MrPaulAR/PB_16/SM_Receiver_Out_SMD/Receiver_Out.kicad_pcb

## KiCad design SM_Receiver_Out_SMD/Receiver_Out.kicad_pcb (2026-10-05)

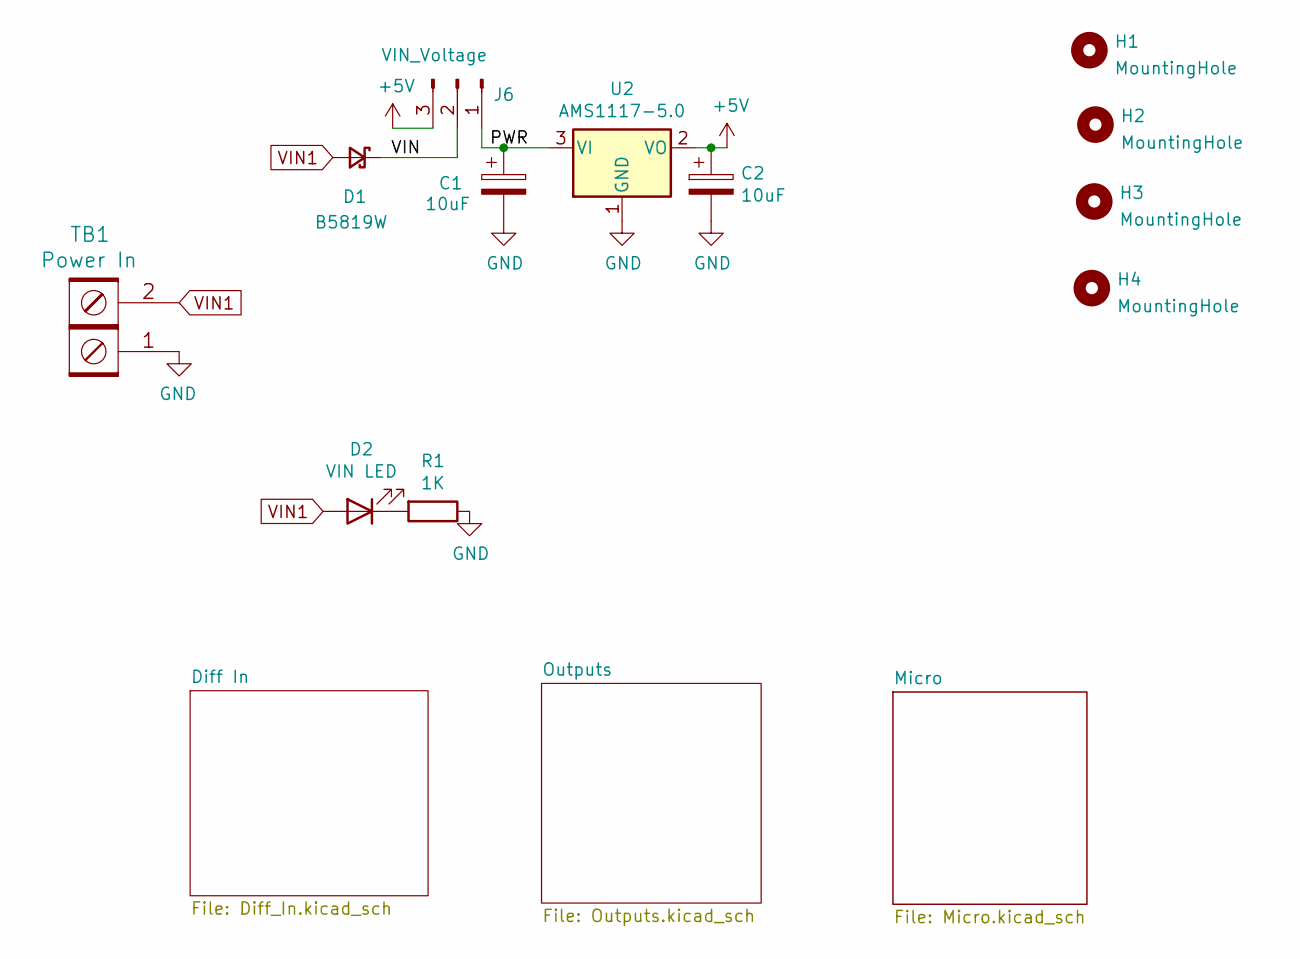
[picture p2: schematic Receiver_Out.kicad_sch, SM Receiver Out SMD]

Parts:
C1, C2: 10uF; C_0805_2012Metric_Pad1.18x1.45mm_HandSolder; MPN GRM21BR61E106KA73L; Digi-Key_PN 490-5523-1-ND
D1: B5819W; D_SOD-123; MPN B5819W-TP; LCSC_PN C8598
D2: VIN LED; LED_0603_1608Metric_Pad1.05x0.95mm_HandSolder; MPN 150080RS75000; Digi-Key_PN 732-4984-1-ND
H1, H2, H3, H4: MountingHole; MountingHole_3.7mm
J6: VIN_Voltage; PinHeader_1x03_P2.54mm_Vertical; MPN 61300311121; Digi-Key_PN 732-5316-ND
R1: 1K; R_0603_1608Metric_Pad0.98x0.95mm_HandSolder; MPN RC0603FR-071KL; Digi-Key_PN 311-1.00KHRCT-ND
TB1: Power In; BARRIER_BLOCK_1ROW_2POS; MPN 4DB-P108-02; Digi-Key_PN A98472-ND
U2: AMS1117-5.0; SOT-223-3_TabPin2; MPN LM1117MPX-50NOPB; LCSC_PN C6187

Connections:
+5V: C2.1, J6.3, U2.2 (VO); also elsewhere on the board
/PWR: C1.1, J6.1, U2.3 (VI)
/VIN: D1.1 (K), J6.2
GND: C1.2, C2.2, R1.1, TB1.1, U2.1 (GND); also elsewhere on the board
unnamed: D2.1 (K), R1.2
VIN1: D1.2 (A), D2.2 (A), TB1.2; also elsewhere on the board

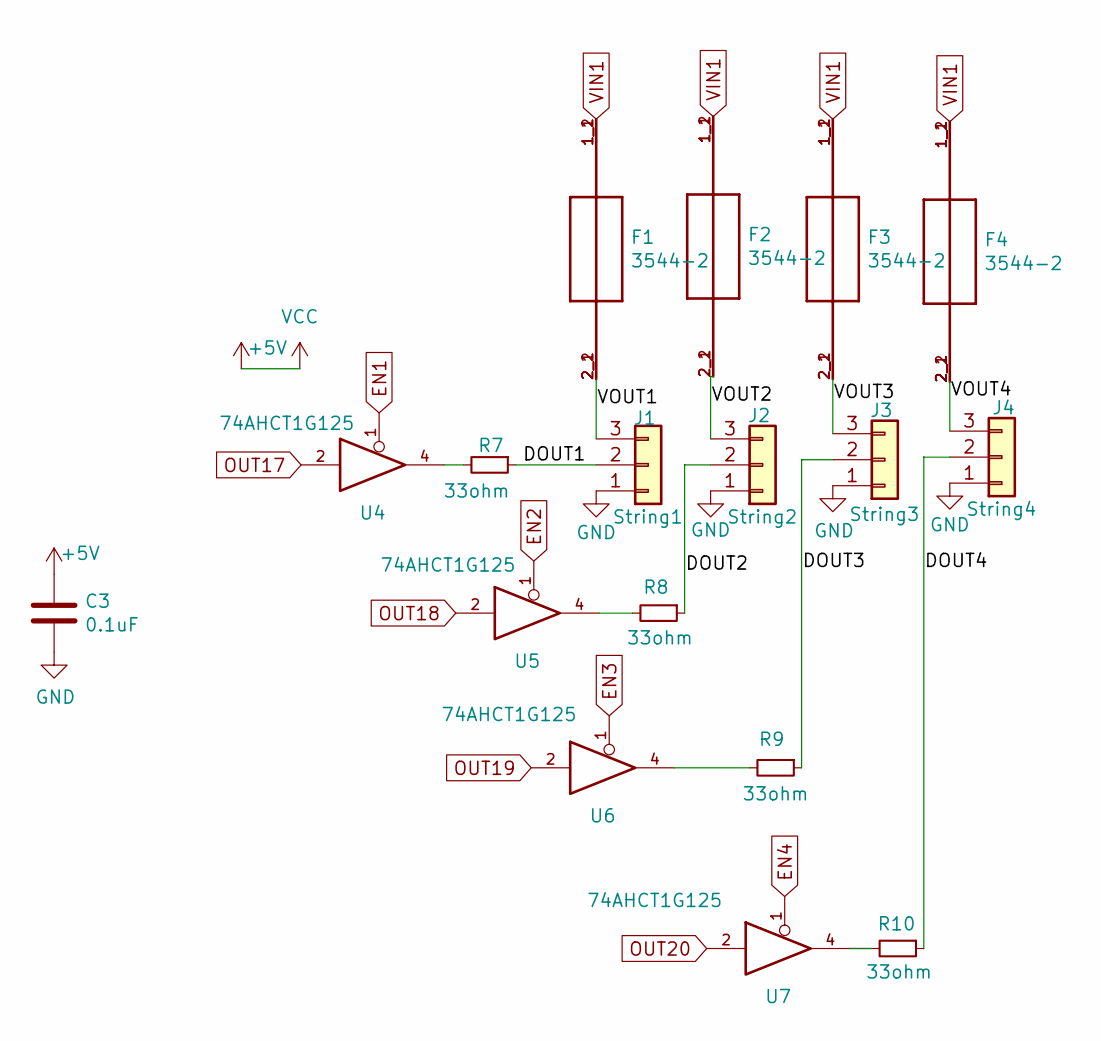
[picture p3: schematic Outputs.kicad_sch, SM Receiver Out SMD]

Parts:
C3: 0.1uF; C_0603_1608Metric_Pad1.08x0.95mm_HandSolder; MPN CL10B104KB8NNWC; Digi-Key_PN 1276-1935-2-ND
F1, F2, F3, F4: 3544-2; FUSE_3544-2; MPN 3544-2; Digi-Key_PN 36-3544-2-ND
J1: String1; PhoenixContact_MCV_1,5_3-G-3.5_1x03_P3.50mm_Vertical; MPN 1843619/OSTTJ0311530; Digi-Key_PN 277-5737-ND/ED10555-ND
J2: String2; PhoenixContact_MCV_1,5_3-G-3.5_1x03_P3.50mm_Vertical; MPN 1843619/OSTTJ0311530; Digi-Key_PN 277-5737-ND/ED10555-ND
J3: String3; PhoenixContact_MCV_1,5_3-G-3.5_1x03_P3.50mm_Vertical; MPN 1843619/OSTTJ0311530; Digi-Key_PN 277-5737-ND/ED10555-ND
J4: String4; PhoenixContact_MCV_1,5_3-G-3.5_1x03_P3.50mm_Vertical; MPN 1843619/OSTTJ0311530; Digi-Key_PN 277-5737-ND/ED10555-ND
R7, R8, R9, R10: 33ohm; R_0603_1608Metric_Pad0.98x0.95mm_HandSolder; MPN RC0603JR-0733RL; LCSC_PN C23140
U4, U5, U6, U7: 74AHCT1G125; TSOP-5_1.65x3.05mm_P0.95mm; MPN 74AHCT1G125W5-7; Digi-Key_PN 74AHCT1G125W5-7DICT-ND

Connections:
+5V: C3.1, U4.5 (VCC), U5.5 (VCC), U6.5 (VCC), U7.5 (VCC); also elsewhere on the board
/Outputs/DOUT1: J1.2, R7.1
/Outputs/DOUT2: J2.2, R8.1
/Outputs/DOUT3: J3.2, R9.1
/Outputs/DOUT4: J4.2, R10.1
/Outputs/VOUT1: F1.2_1 (2), F1.2_2 (2), J1.3
/Outputs/VOUT2: F2.2_1 (2), F2.2_2 (2), J2.3
/Outputs/VOUT3: F3.2_1 (2), F3.2_2 (2), J3.3
/Outputs/VOUT4: F4.2_1 (2), F4.2_2 (2), J4.3
EN1: U4.1; also elsewhere on the board
EN2: U5.1; also elsewhere on the board
EN3: U6.1; also elsewhere on the board
EN4: U7.1; also elsewhere on the board
GND: C3.2, J1.1, J2.1, J3.1, J4.1, U4.3 (GND), U5.3 (GND), U6.3 (GND), U7.3 (GND); also elsewhere on the board
unnamed: R7.2, U4.4
unnamed: R8.2, U5.4
unnamed: R9.2, U6.4
unnamed: R10.2, U7.4
OUT17: U4.2; also elsewhere on the board
OUT18: U5.2; also elsewhere on the board
OUT19: U6.2; also elsewhere on the board
OUT20: U7.2; also elsewhere on the board
VIN1: F1.1_1 (1), F1.1_2 (1), F2.1_1 (1), F2.1_2 (1), F3.1_1 (1), F3.1_2 (1), F4.1_1 (1), F4.1_2 (1); also elsewhere on the board

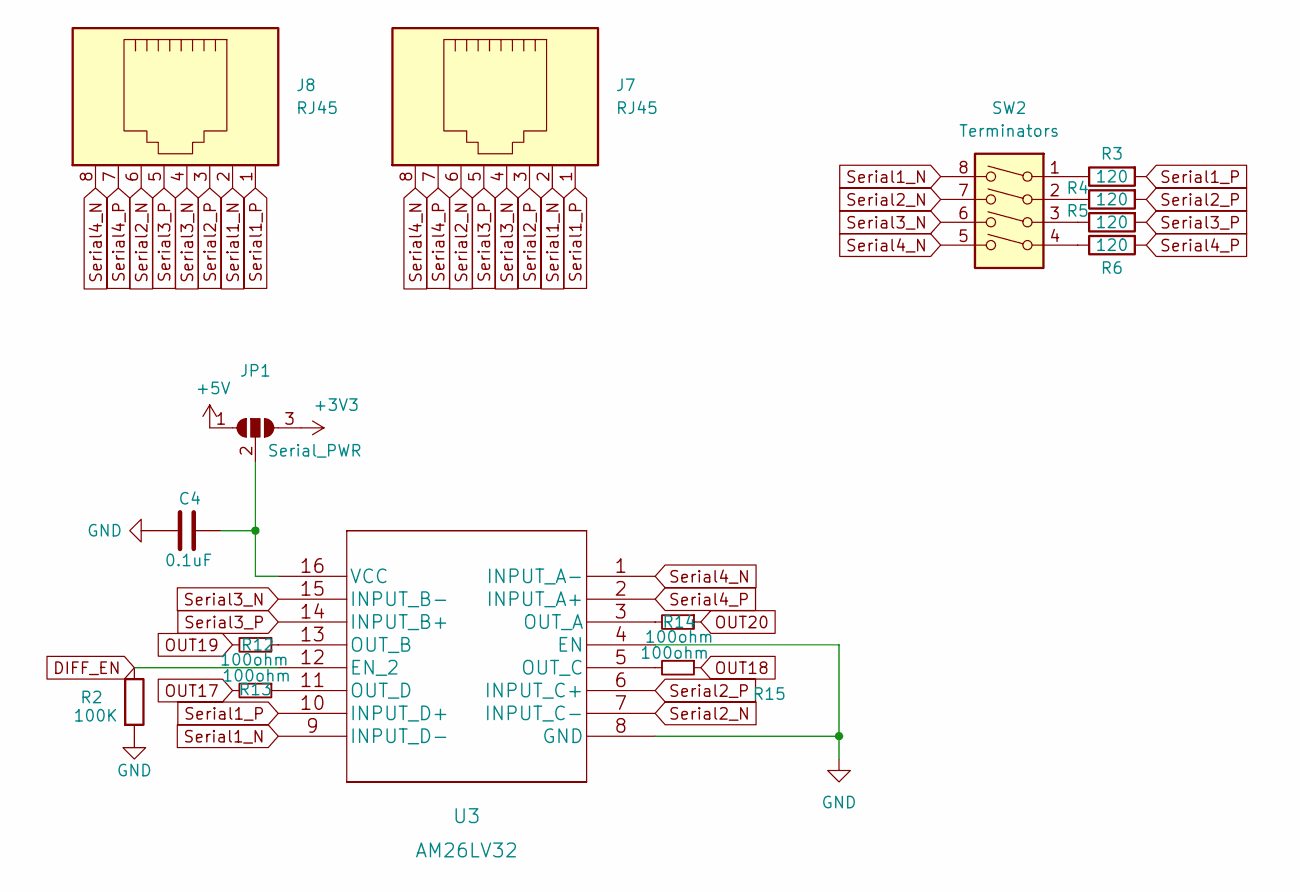
[picture p4: schematic Diff_In.kicad_sch, SM Receiver Out SMD]

Parts:
C4: 0.1uF; C_0603_1608Metric_Pad1.08x0.95mm_HandSolder; MPN CL10B104KB8NNWC; Digi-Key_PN 1276-1935-2-ND
J7, J8: RJ45; RJ45_Amphenol_54602-x08_Horizontal; MPN A-2014-2-4-R; Digi-Key_PN AE10392-ND
JP1: Serial_PWR; SolderJumper-3_P2.0mm_Open_TrianglePad1.0x1.5mm
R2: 100K; R_0603_1608Metric_Pad0.98x0.95mm_HandSolder; MPN RT0603BRD07100KL; Digi-Key_PN YAG1235CT-ND
R3, R4, R5, R6: 120; R_0603_1608Metric_Pad0.98x0.95mm_HandSolder; MPN CRGCQ0603F120R; LCSC_PN C22787
R12, R13: 100ohm; R_0603_1608Metric_Pad0.98x0.95mm_HandSolder; LCSC_PN C22775
R14, R15: 100ohm; R_0603_1608Metric_Pad0.98x0.95mm_HandSolder; MPN RC0603FR-07100RL; LCSC_PN C22775
SW2: Terminators; SW_DIP_SPSTx04_Slide_6.7x11.72mm_W7.62mm_P2.54mm_LowProfile; MPN DS04-254-1L-04BK; Digi-Key_PN 2223-DS04-254-1L-04BK-ND
U3: AM26LV32; SOIC-16_3.9x9.9mm_P1.27mm; MPN AM26LV32IDR; Digi-Key_PN 296-18090-1-ND

Connections:
+3V3: JP1.3 (B); also elsewhere on the board
+5V: JP1.1 (A); also elsewhere on the board
DIFF_EN: R2.1, U3.12 (EN_2); also elsewhere on the board
GND: C4.2, R2.2, U3.4 (EN), U3.8 (GND); also elsewhere on the board
unnamed: C4.1, JP1.2 (C), U3.16 (VCC)
unnamed: R3.1, SW2.1
unnamed: R4.1, SW2.2
unnamed: R5.1, SW2.3
unnamed: R6.1, SW2.4
unnamed: R14.2, U3.3 (OUT_A)
unnamed: R12.1, U3.13 (OUT_B)
unnamed: R15.2, U3.5 (OUT_C)
unnamed: R13.1, U3.11 (OUT_D)
OUT17: R13.2; also elsewhere on the board
OUT18: R15.1; also elsewhere on the board
OUT19: R12.2; also elsewhere on the board
OUT20: R14.1; also elsewhere on the board
Serial1_N: J7.2, J8.2, SW2.8, U3.9 (INPUT_D-)
Serial1_P: J7.1, J8.1, R3.2, U3.10 (INPUT_D+)
Serial2_N: J7.6, J8.6, SW2.7, U3.7 (INPUT_C-)
Serial2_P: J7.3, J8.3, R4.2, U3.6 (INPUT_C+)
Serial3_N: J7.4, J8.4, SW2.6, U3.15 (INPUT_B-)
Serial3_P: J7.5, J8.5, R5.2, U3.14 (INPUT_B+)
Serial4_N: J7.8, J8.8, SW2.5, U3.1 (INPUT_A-)
Serial4_P: J7.7, J8.7, R6.2, U3.2 (INPUT_A+)

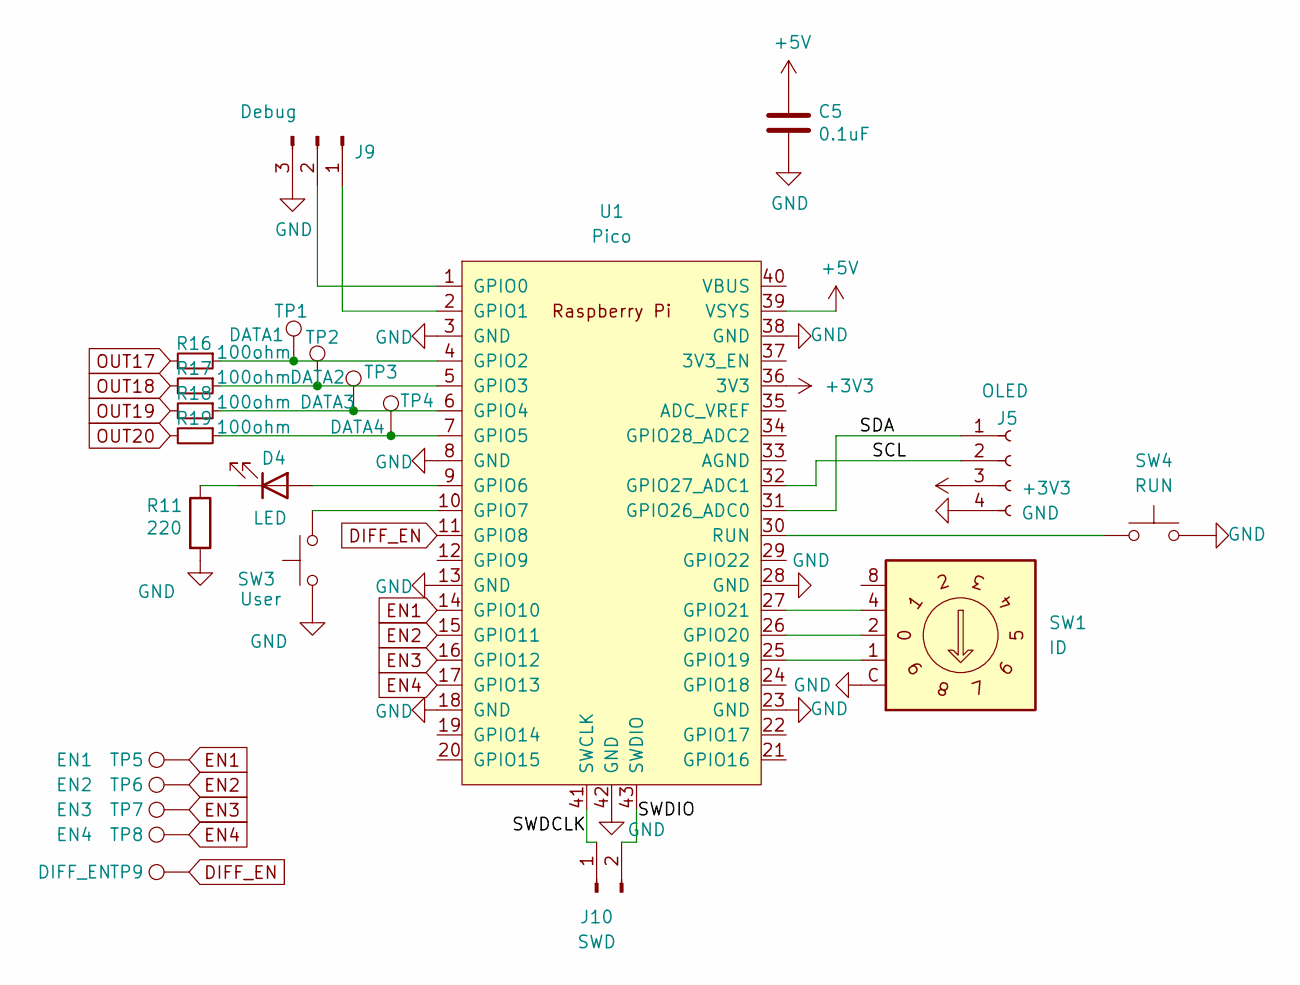
[picture p5: schematic Micro.kicad_sch, SM Receiver Out SMD]

Parts:
C5: 0.1uF; C_0603_1608Metric_Pad1.08x0.95mm_HandSolder; MPN CL10B104KB8NNWC; Digi-Key_PN 1276-1935-2-ND
D4: LED; LED_0603_1608Metric_Pad1.05x0.95mm_HandSolder; MPN 150080RS75000; Digi-Key_PN 732-4984-1-ND
J5: OLED; OLED-SSD1306-128X64-I2C-THT; MPN PPTC041LFBN-RC; Digi-Key_PN S7002-ND
J9: Debug; PinHeader_1x03_P2.54mm_Vertical; MPN 61300311121; Digi-Key_PN 732-5316-ND
J10: SWD; 1x02_Horizontal_SMD; MPN 61300211121; Digi-Key_PN 732-5315-ND
R11: 220; R_0603_1608Metric_Pad0.98x0.95mm_HandSolder; MPN RMCF0603FT220R; Digi-Key_PN RMCF0603FT220RTR-ND
R16, R17, R18, R19: 100ohm; R_0603_1608Metric_Pad0.98x0.95mm_HandSolder; MPN RC0603FR-07100RL; LCSC_PN C22775
SW1: ID; Nidec_Copal_SH-7010C; MPN SD-2010; Digi-Key_PN 563-1069-ND
SW3: User; SW_Push_1P1T_NO_6x6mm_H9.5mm; MPN PTS645SL50SMTR92 LFS; Digi-Key_PN CKN9088CT-ND
SW4: RUN; SW_Push_1P1T_NO_6x6mm_H9.5mm; MPN PTS645SL50SMTR92 LFS; Digi-Key_PN CKN9088CT-ND
TP1: DATA1; TestPoint_Pad_D1.5mm
TP2: DATA2; TestPoint_Pad_D1.5mm
TP3: DATA3; TestPoint_Pad_D1.5mm
TP4: DATA4; TestPoint_Pad_D1.5mm
TP5: EN1; TestPoint_Pad_D1.5mm
TP6: EN2; TestPoint_Pad_D1.5mm
TP7: EN3; TestPoint_Pad_D1.5mm
TP8: EN4; TestPoint_Pad_D1.5mm
TP9: DIFF_EN; TestPoint_Pad_D1.5mm
U1: Pico; RPi_Pico_SMD_TH; MPN 2648-SC0915CT-ND; Digi-Key_PN SC0915

Connections:
+3V3: J5.3, U1.36 (3V3); also elsewhere on the board
+5V: C5.1, U1.39 (VSYS); also elsewhere on the board
/Micro/SCL: J5.2, U1.32 (GPIO27_ADC1)
/Micro/SDA: J5.1, U1.31 (GPIO26_ADC0)
/Micro/SWDCLK: J10.1, U1.41 (SWCLK)
/Micro/SWDIO: J10.2, U1.43 (SWDIO)
DIFF_EN: TP9.1, U1.11 (GPIO8); also elsewhere on the board
EN1: TP5.1, U1.14 (GPIO10); also elsewhere on the board
EN2: TP6.1, U1.15 (GPIO11); also elsewhere on the board
EN3: TP7.1, U1.16 (GPIO12); also elsewhere on the board
EN4: TP8.1, U1.17 (GPIO13); also elsewhere on the board
GND: C5.2, J5.4, J9.3, R11.2, SW1.C, SW3.1, SW4.2, U1.3 (GND), U1.8 (GND), U1.13 (GND), U1.18 (GND), U1.23 (GND), U1.28 (GND), U1.38 (GND), U1.42 (GND); also elsewhere on the board
unnamed: D4.2 (A), U1.9 (GPIO6)
unnamed: D4.1 (K), R11.1
unnamed: J9.1, U1.2 (GPIO1)
unnamed: J9.2, U1.1 (GPIO0)
unnamed: R16.1, TP1.1, U1.4 (GPIO2)
unnamed: R17.1, TP2.1, U1.5 (GPIO3)
unnamed: R18.1, TP3.1, U1.6 (GPIO4)
unnamed: R19.1, TP4.1, U1.7 (GPIO5)
unnamed: SW3.2, U1.10 (GPIO7)
unnamed: SW1.1, U1.25 (GPIO19)
unnamed: SW1.2, U1.26 (GPIO20)
unnamed: SW1.4, U1.27 (GPIO21)
unnamed: SW4.1, U1.30 (RUN)
OUT17: R16.2; also elsewhere on the board
OUT18: R17.2; also elsewhere on the board
OUT19: R18.2; also elsewhere on the board
OUT20: R19.2; also elsewhere on the board

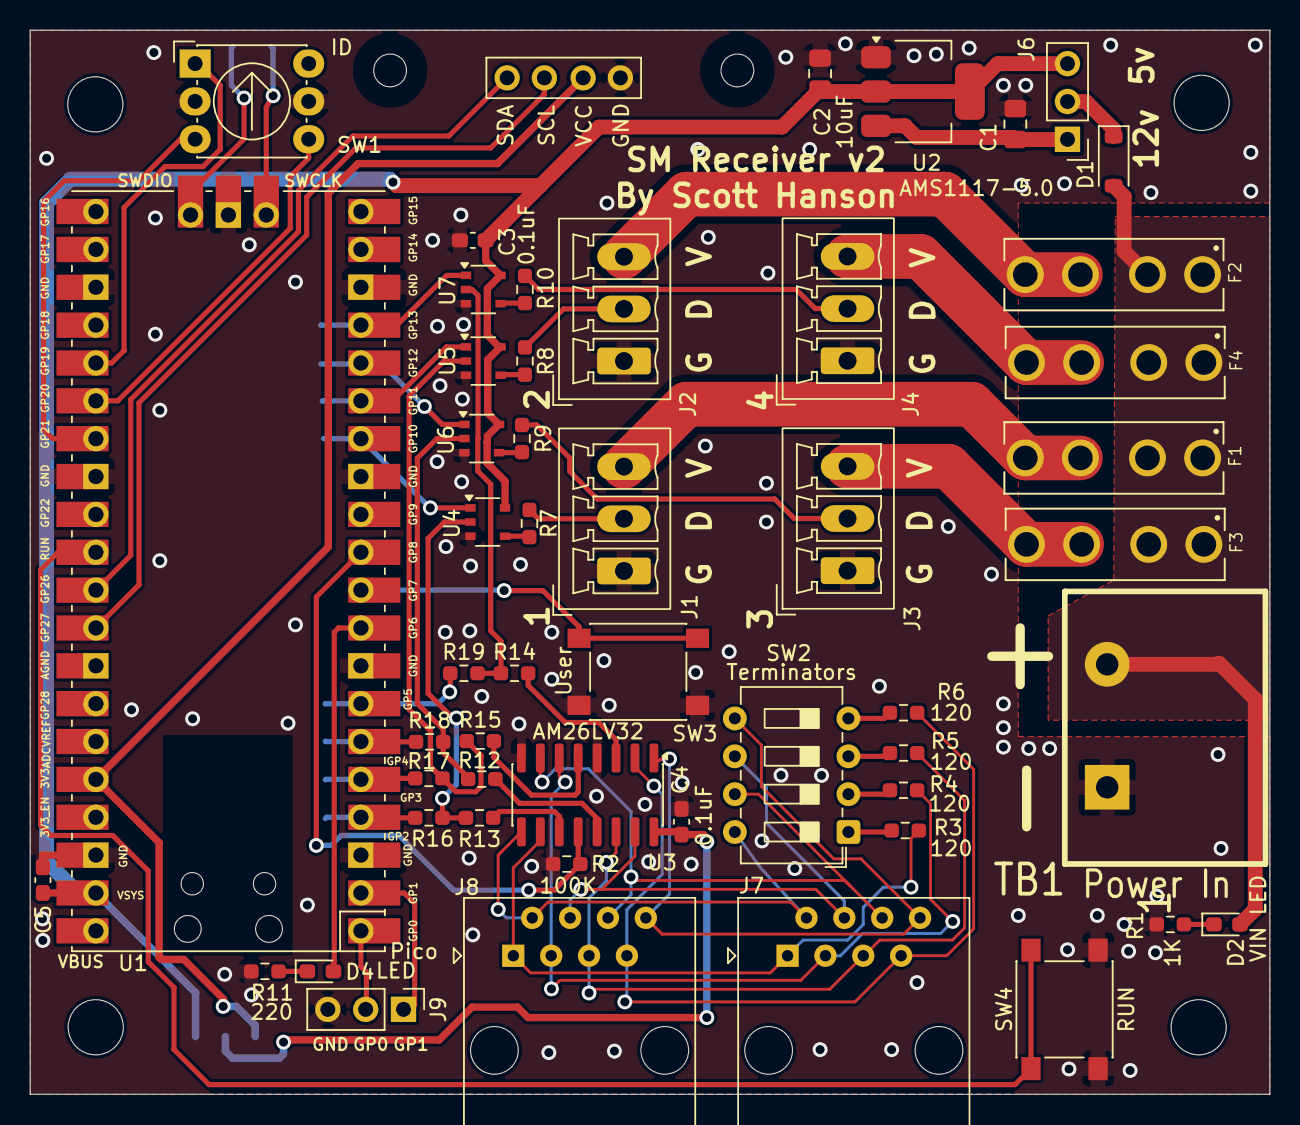
[picture p6: board SM_Receiver_Out_SMD/Receiver_Out.kicad_pcb from above]

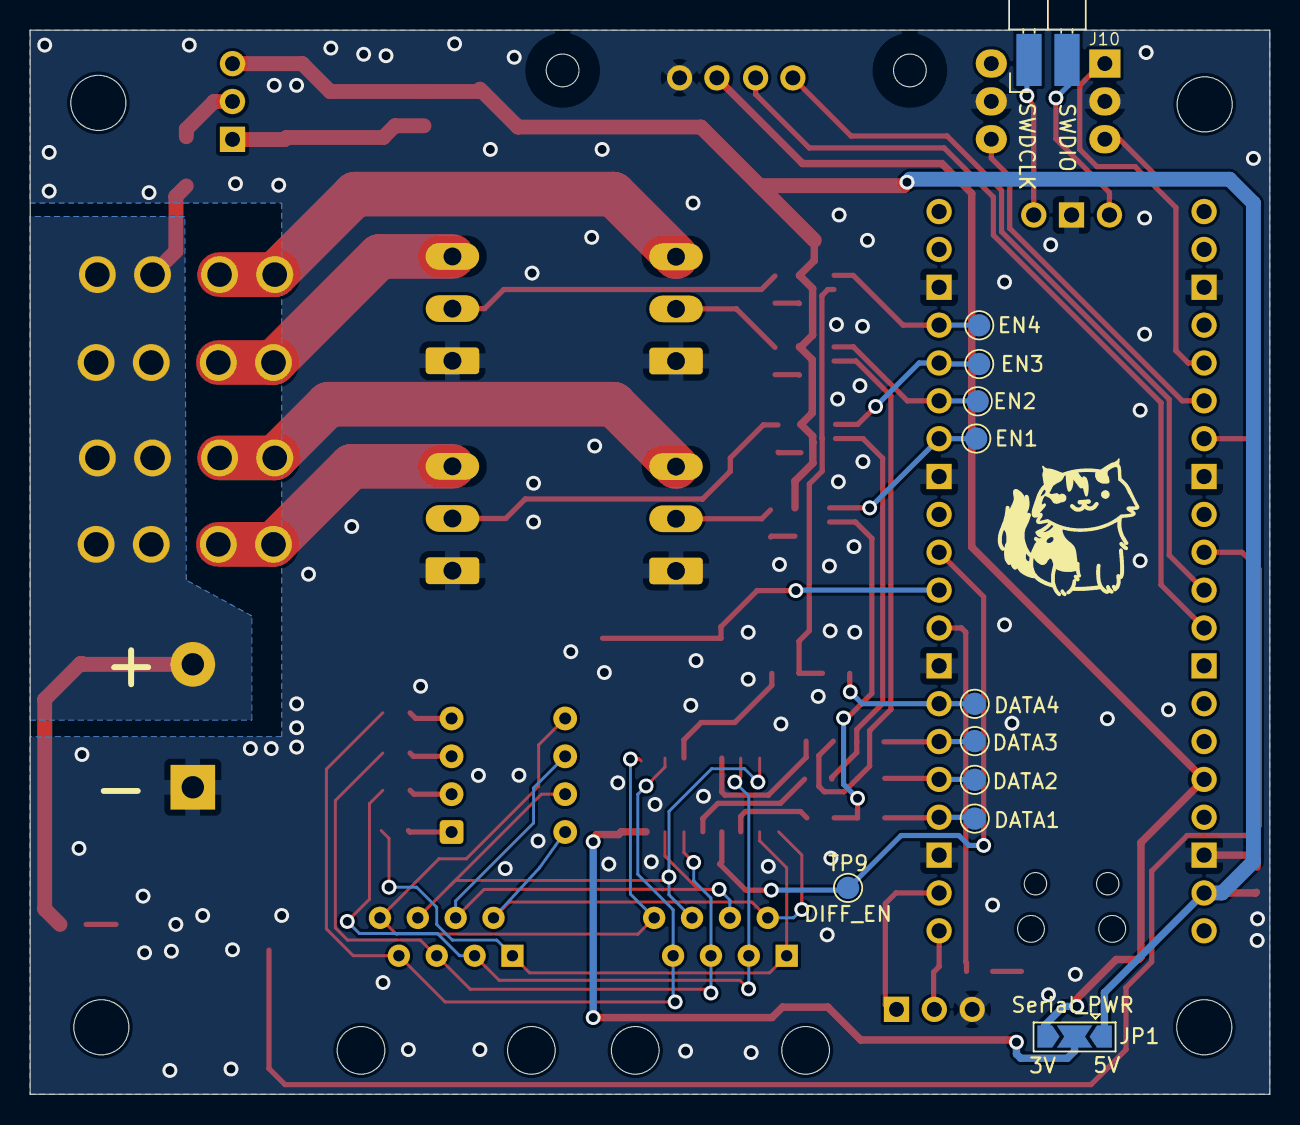
[picture p7: board SM_Receiver_Out_SMD/Receiver_Out.kicad_pcb from below]

Board: 2 copper layers, 83.2 x 71.4 mm, 67 parts (11 on the bottom side), 62 nets.
