MrPaulAR/PB_16/Receiver_Out_SMD/Receiver_Out.kicad_pcb

## KiCad design Receiver_Out_SMD/Receiver_Out.kicad_pcb (2026-08-29)

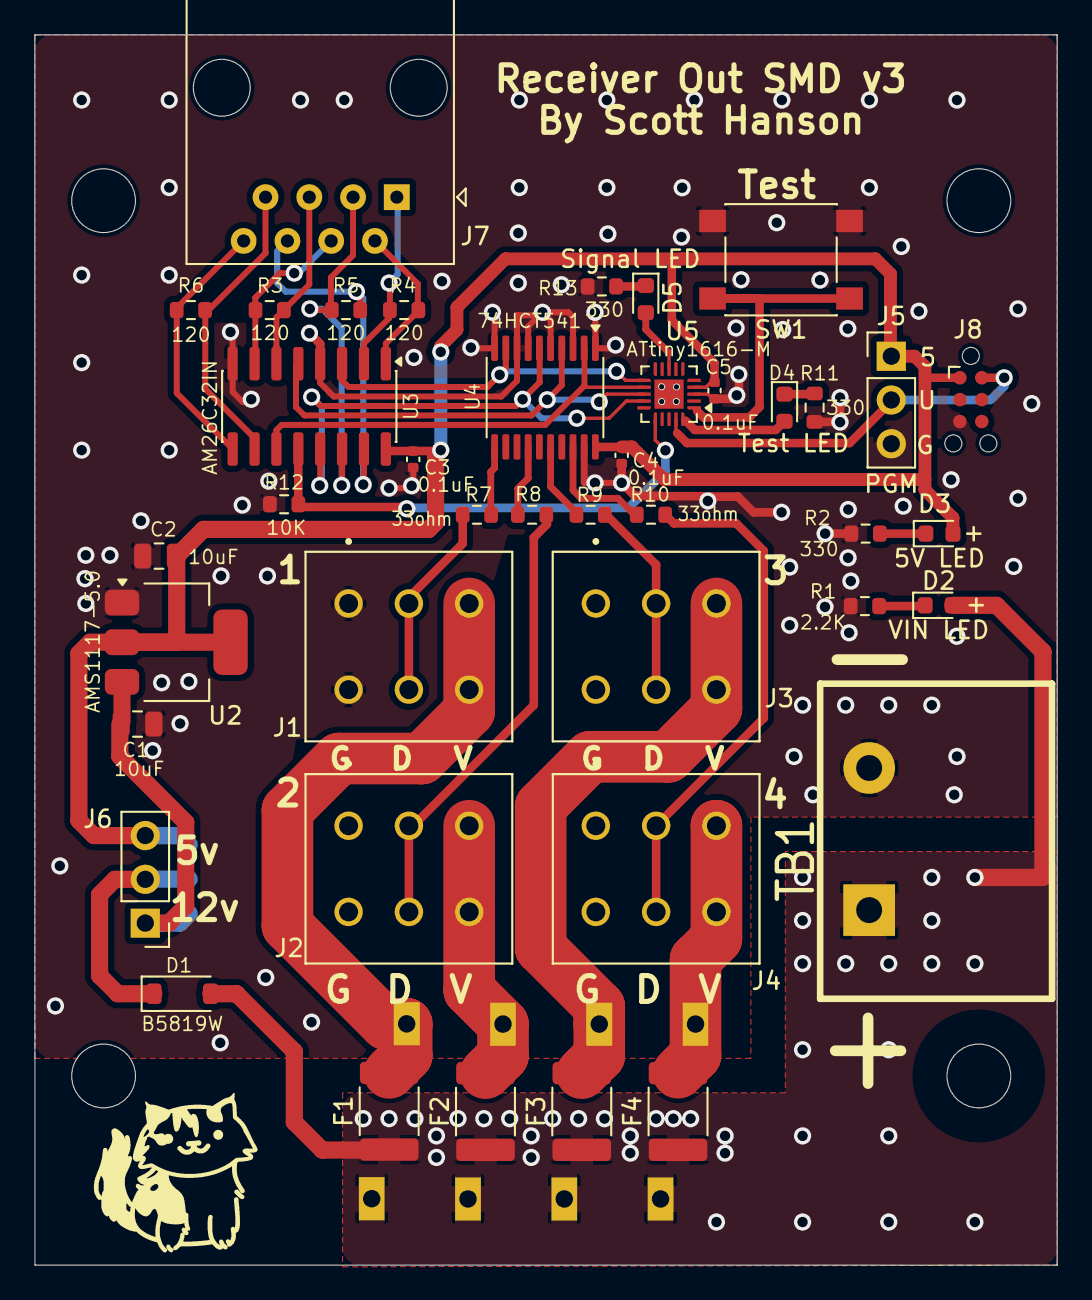
[picture p8: board Receiver_Out_SMD/Receiver_Out.kicad_pcb from above]

Board: 2 copper layers, 59.3 x 71.4 mm, 46 parts (1 on the bottom side), 38 nets.

Parts:
C1, C2: 10uF; C_0805_2012Metric
C3, C4, C5: 0.1uF; C_0402_1005Metric
D1: B5819W; D_SOD-123
D2: VIN LED; LED_0603_1608Metric
D3: 5V LED; LED_0603_1608Metric
D4: Test LED; LED_0603_1608Metric
D5: Signal LED; LED_0603_1608Metric
F1, F2, F3, F4: 1812L400/16GR; Fuse_1812_4532Metric
H1, H2, H3, H4: MountingHole; MountingHole_3.7mm
J1: String1; PHOENIX_1864299
J2: String2; PHOENIX_1864299
J3: String3; PHOENIX_1864299
J4: String4; PHOENIX_1864299
J5: PGM; PinHeader_1x03_P2.54mm_Vertical
J6: VIN_Voltage; PinHeader_1x03_P2.54mm_Vertical
J7: RJ45; RJ45_Amphenol_54602-x08_Horizontal
J8: Conn_ARM_SWD_TagConnect_TC2030-NL; Tag-Connect_TC2030-IDC-NL_2x03_P1.27mm_Vertical
JP1: PWR_JMP; SolderJumper-3_P2.0mm_Open_TrianglePad1.0x1.5mm
R1: 2.2K; R_0603_1608Metric
R2, R11, R13: 330; R_0603_1608Metric
R3, R4, R5, R6: 120; R_0603_1608Metric
R7, R8, R9, R10: 33ohm; R_0603_1608Metric
R12: 10K; R_0603_1608Metric
SW1: Test; SW_Push_1P1T_NO_6x6mm_H9.5mm
TB1: Power In; BARRIER_BLOCK_1ROW_2POS
U2: AMS1117-5.0; SOT-223-3_TabPin2
U3: AM26C32IN; SOIC-16_3.9x9.9mm_P1.27mm
U4: 74HCT541; TSSOP-20_4.4x6.5mm_P0.65mm
U5: ATtiny1616-M; VQFN-20-1EP_3x3mm_P0.4mm_EP1.7x1.7mm

Connections:
+5V: C2.1, C3.1, C4.1, C5.1, D3.2 (A), J5.1, J6.3, J8.1 (VCC), JP1.1 (A), U2.2 (VO), U3.16 (VCC), U4.20 (VCC), U5.4 (VCC)
/Diff In/Serial1_N: J7.2, R4.1, U3.1 (INPUT_A-)
/Diff In/Serial1_P: J7.1, R4.2, U3.2 (INPUT_A+)
/Diff In/Serial2_N: J7.6, R5.2, U3.15 (INPUT_B-)
/Diff In/Serial2_P: J7.3, R5.1, U3.14 (INPUT_B+)
/Diff In/Serial3_N: J7.4, R3.2, U3.7 (INPUT_C-)
/Diff In/Serial3_P: J7.5, R3.1, U3.6 (INPUT_C+)
/Diff In/Serial4_N: J7.8, R6.1, U3.9 (INPUT_D-)
/Diff In/Serial4_P: J7.7, R6.2, U3.10 (INPUT_D+)
/Outputs/DOUT1: J1.2, R7.1
/Outputs/DOUT2: J2.2, R8.1
/Outputs/DOUT3: J3.2, R9.1
/Outputs/DOUT4: J4.2, R10.1
/Outputs/VOUT1: F1.2, J1.3
/Outputs/VOUT2: F2.2, J2.3
/Outputs/VOUT3: F3.2, J3.3
/Outputs/VOUT4: F4.2, J4.3
GND: C1.2, C2.2, C3.2, C4.2, C5.2, J1.1, J2.1, J3.1, J4.1, J5.3, J8.5 (GND), R1.1, R2.1, R11.1, R12.2, R13.1, SW1.2, TB1.2, U2.1 (GND), U3.4 (EN), U3.8 (GND), U4.1 (G1), U4.3 (A1), U4.5 (A3), U4.7 (A5), U4.8 (A6), U4.10 (GND), U4.19 (G2), U5.3 (GND), U5.21 (GND)
unnamed: D2.1 (K), R1.2
unnamed: D3.1 (K), R2.2
unnamed: D4.1 (K), R11.2
unnamed: D5.1 (K), R13.2
unnamed: R10.2, U4.18 (Y0)
unnamed: R9.2, U4.16 (Y2)
unnamed: R8.2, U4.14 (Y4)
unnamed: R7.2, U4.11 (Y7)
unnamed: SW1.1, U5.1 (PA2)
OUT17: U3.3 (OUT_A), U4.9 (A7), U5.11 (PB3)
OUT18: U3.13 (OUT_B), U4.6 (A4), U5.14 (PB0)
OUT19: U3.5 (OUT_C), U4.4 (A2), U5.13 (PB1)
OUT20: U3.11 (OUT_D), U4.2 (A0), U5.12 (PB2)
OUT_EN: R12.1, U3.12 (EN_2), U5.16 (PC1)
PWR: C1.1, J6.1, JP1.3 (B), U2.3 (VI)
SIGNLED: D5.2 (A), U5.8 (PA7)
TESTLED: D4.2 (A), U5.20 (PA1)
UPDI_DATA: J5.2, J8.2 (SWDIO), U5.19 (~RESET/PA0)
VIN: D1.1 (K), J6.2, JP1.2 (C)
VIN1: D1.2 (A), D2.2 (A), F1.1, F2.1, F3.1, F4.1, TB1.1
