MrPaulAR/PB_16/(commit log)

2026-08-27 new header
    [BOM-Receiver_Out.csv, Outputs.kicad_sch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]
2026-08-27 Change header 3D model paths to project-relative format
    Updated model paths to use project-relative references.
    [Receiver_Out.kicad_pcb]
2026-08-29 receiver improve silkscreen
    [CPL-Receiver_Out.csv, Receiver_Out-CuBottom.gbr, Receiver_Out-CuTop.gbr, Receiver_Out-MaskBottom.gbr, Receiver_Out-MaskTop.gbr, Receiver_Out-NPTH.drl, Receiver_Out-PTH.drl, Receiver_Out-PasteBottom.gbr]
2026-10-05 2026 updates
    [Diff_In.kicad_sch, Micro.kicad_sch, Outputs.kicad_sch, Receiver_Out.kicad_pcb, Receiver_Out.kicad_sch]
